DitroniX/IPEM-SIX-ESP32C5-ATM90E32-IoT-Mains-Power-Energy-Monitor/Datasheets and Information/ESP32-C5 Radio Wireless.png

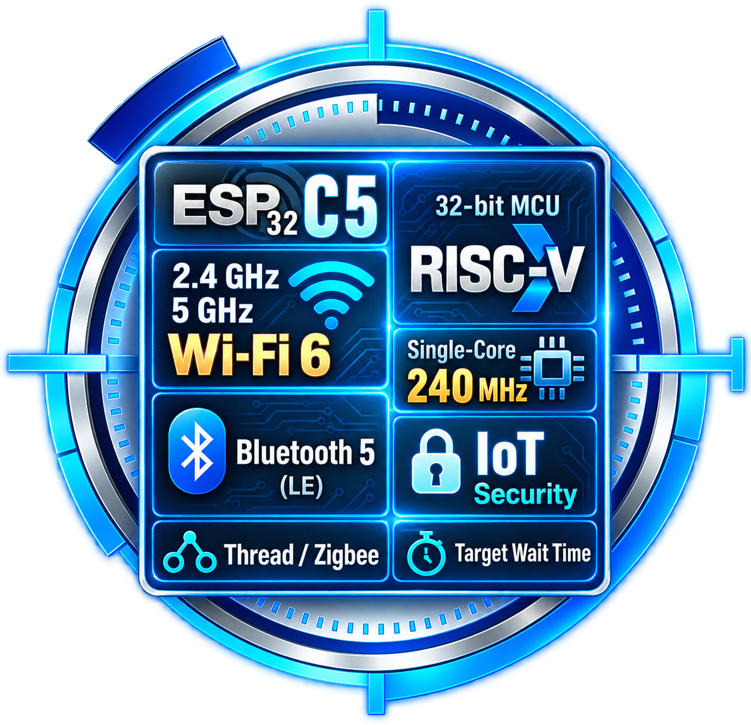
Datasheets and Information/ESP32-C5 Radio Wireless.png
