DitroniX/IPEM-SIX-ESP32C5-ATM90E32-IoT-Mains-Power-Energy-Monitor/Datasheets and Information/IPEM SIX (No Jumpers).png

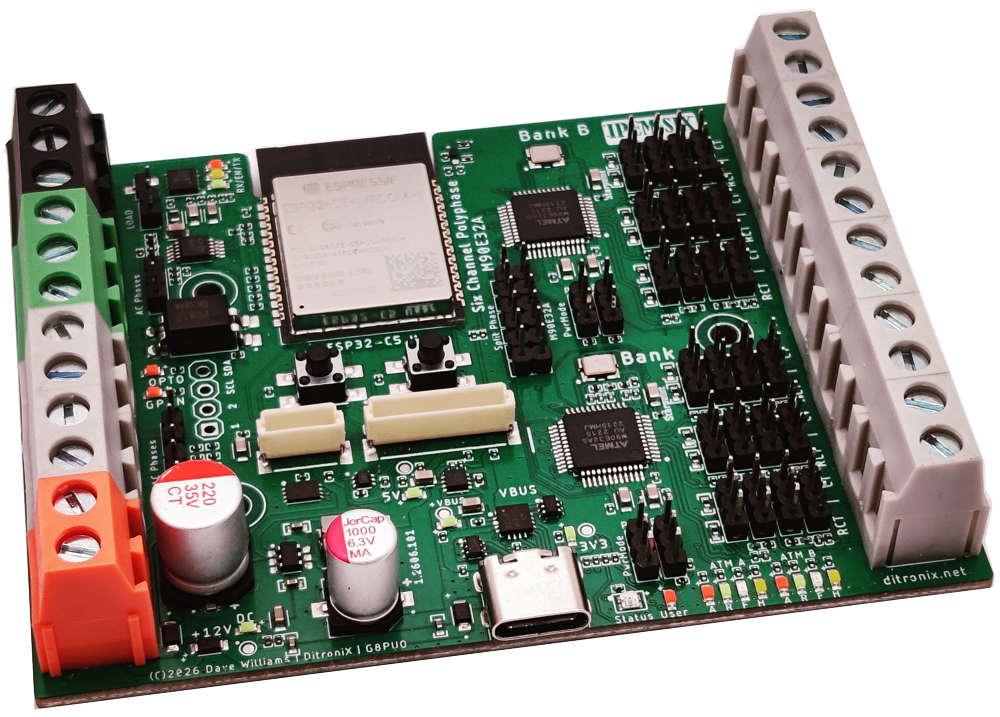
Datasheets and Information/IPEM SIX (No Jumpers).png
