DitroniX/IPEM-SIX-ESP32C5-ATM90E32-IoT-Mains-Power-Energy-Monitor/Datasheets and Information/IPEM SIX - Default Jumpers Split Phase Voltage.png

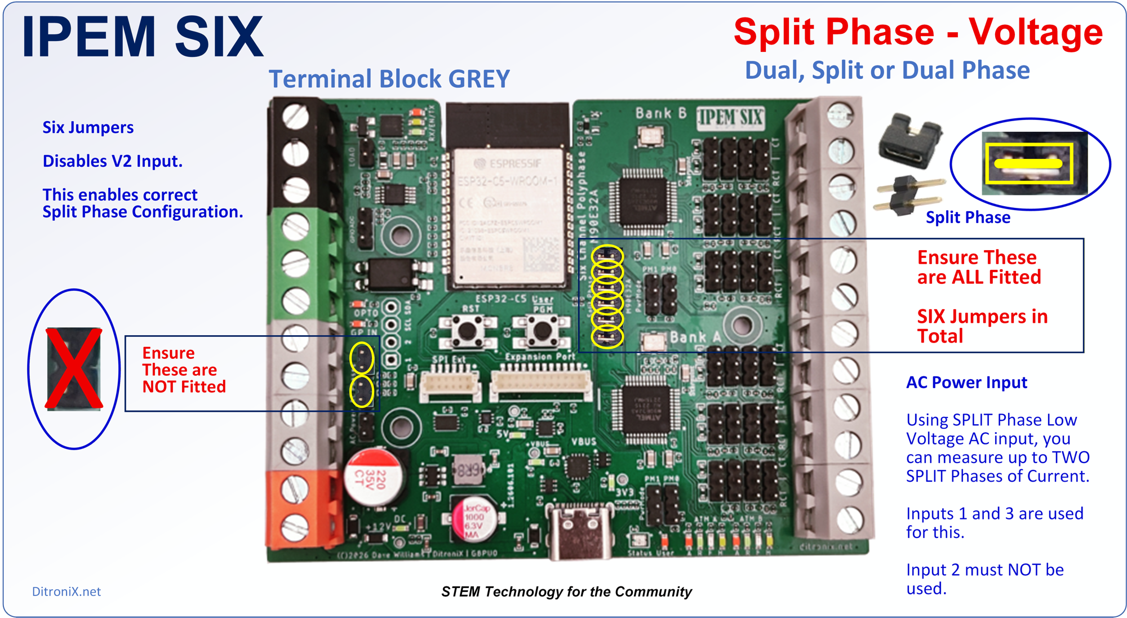
Datasheets and Information/IPEM SIX - Default Jumpers Split Phase Voltage.png
