DitroniX/IPEM-SIX-ESP32C5-ATM90E32-IoT-Mains-Power-Energy-Monitor/Datasheets and Information/IPEM SIX - Hackster 900x725.png

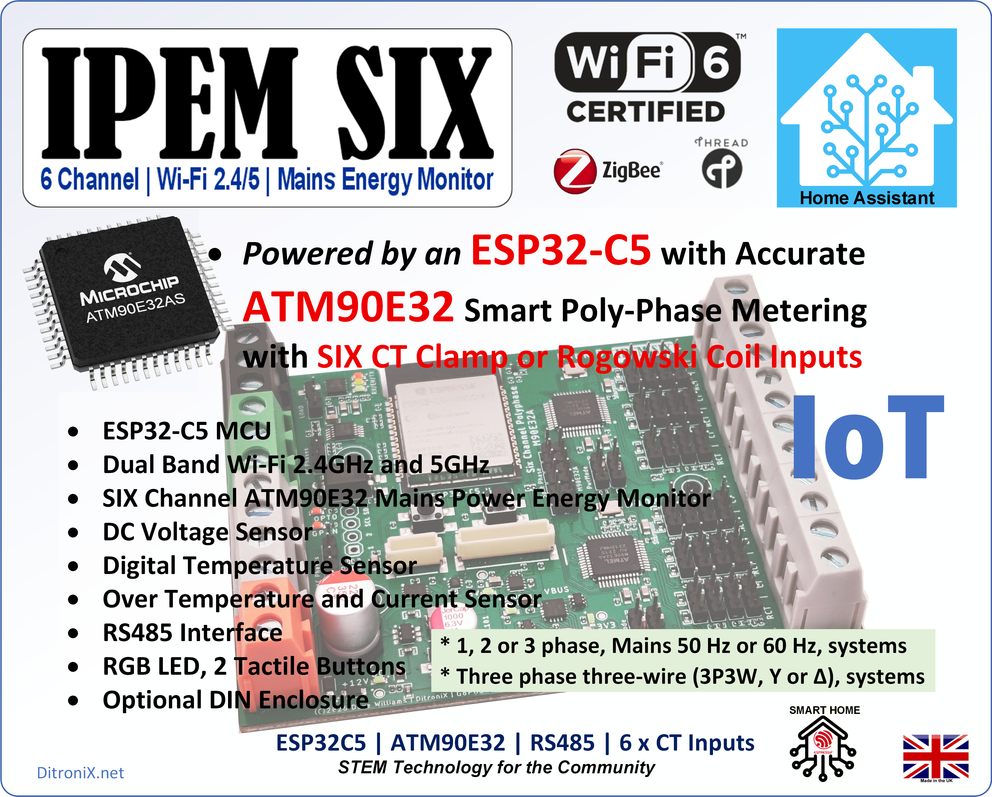
Datasheets and Information/IPEM SIX - Hackster 900x725.png
