DitroniX/IPEM-SIX-ESP32C5-ATM90E32-IoT-Mains-Power-Energy-Monitor/Datasheets and Information/IPEM SIX - OPTO Isolator Output.png

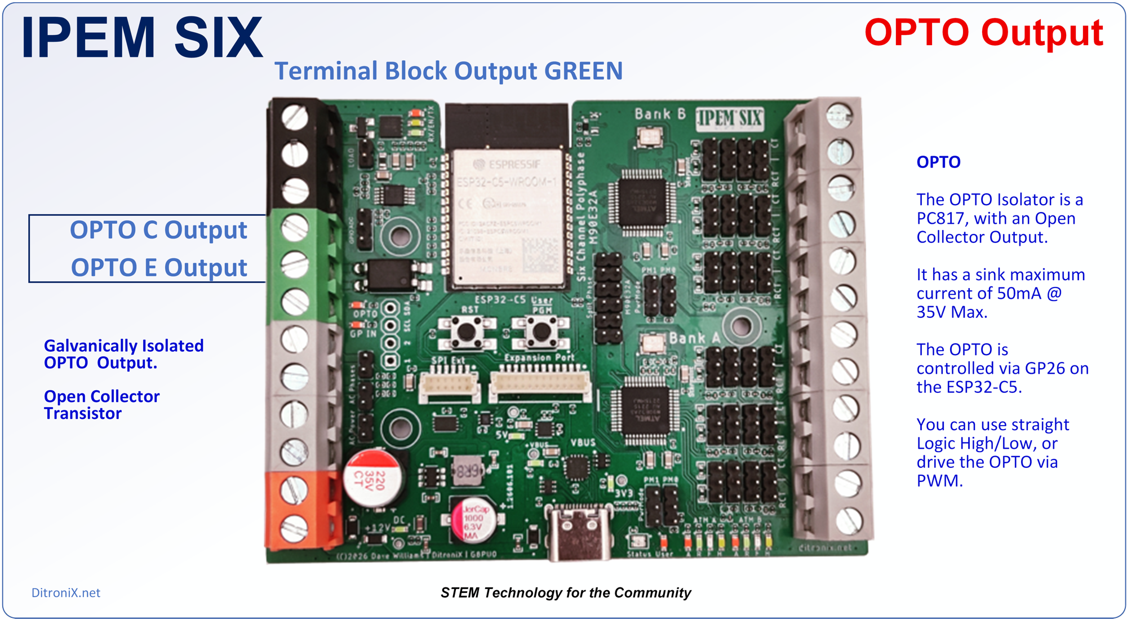
Datasheets and Information/IPEM SIX - OPTO Isolator Output.png
