DitroniX/IPEM-SIX-ESP32C5-ATM90E32-IoT-Mains-Power-Energy-Monitor/Datasheets and Information/IPEM SIX ESP32-C5-WROOM-1-N8R8 ATM90E32AS 1.2607.102 p1.png

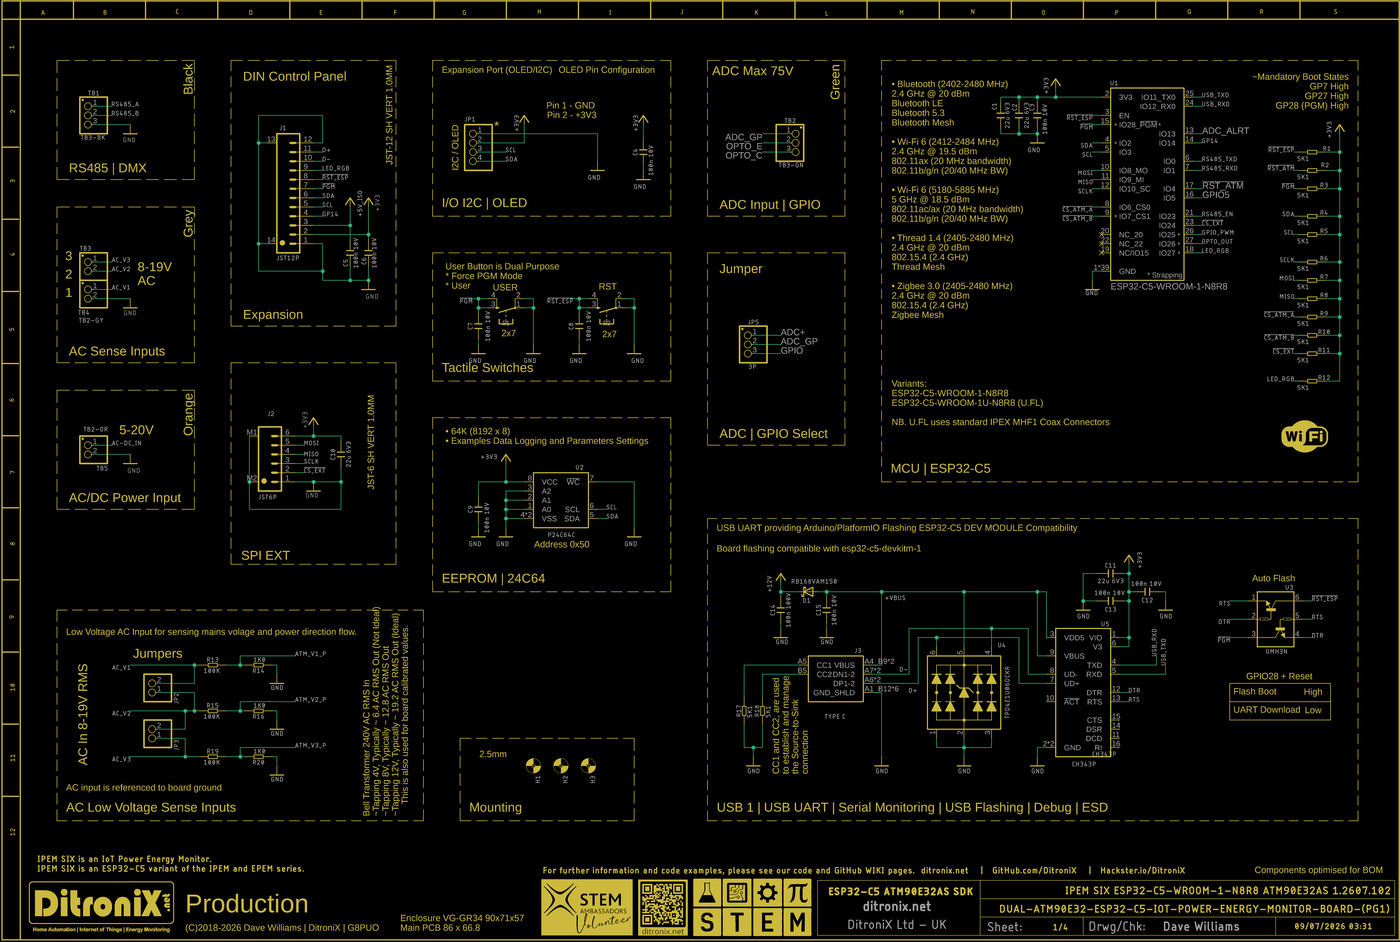
Datasheets and Information/IPEM SIX ESP32-C5-WROOM-1-N8R8 ATM90E32AS 1.2607.102 p1.png
