DitroniX/IPEM-SIX-ESP32C5-ATM90E32-IoT-Mains-Power-Energy-Monitor/(commit log)

2026-04-21 Code Samples
2026-06-18 Create IPEM SIX Pin Matrix.png
2026-06-19 IPEM SIX PCB
2026-06-21 Revise board information and features in README
    Updated board information and added details about current channels and WiFi bands.
2026-06-24 Create IPEM SIX Current Monitoring.png
2026-07-09 Registers for IPEM SIX
    [IPEM SIX ATM90E32 ATM90E36 Registers.xlsx]
2026-07-30 Create IPEM SIX - Default Jumpers Power Mode.png
2026-10-03 Create ESP32-C5 Radio Wireless.png
